turbo-santa/turbo-santa-interface/README.md

turbo-santa-interface
=====================
