turbo-santa/turbo-santa-interface/TurboSantaInterface Schematic.pdf

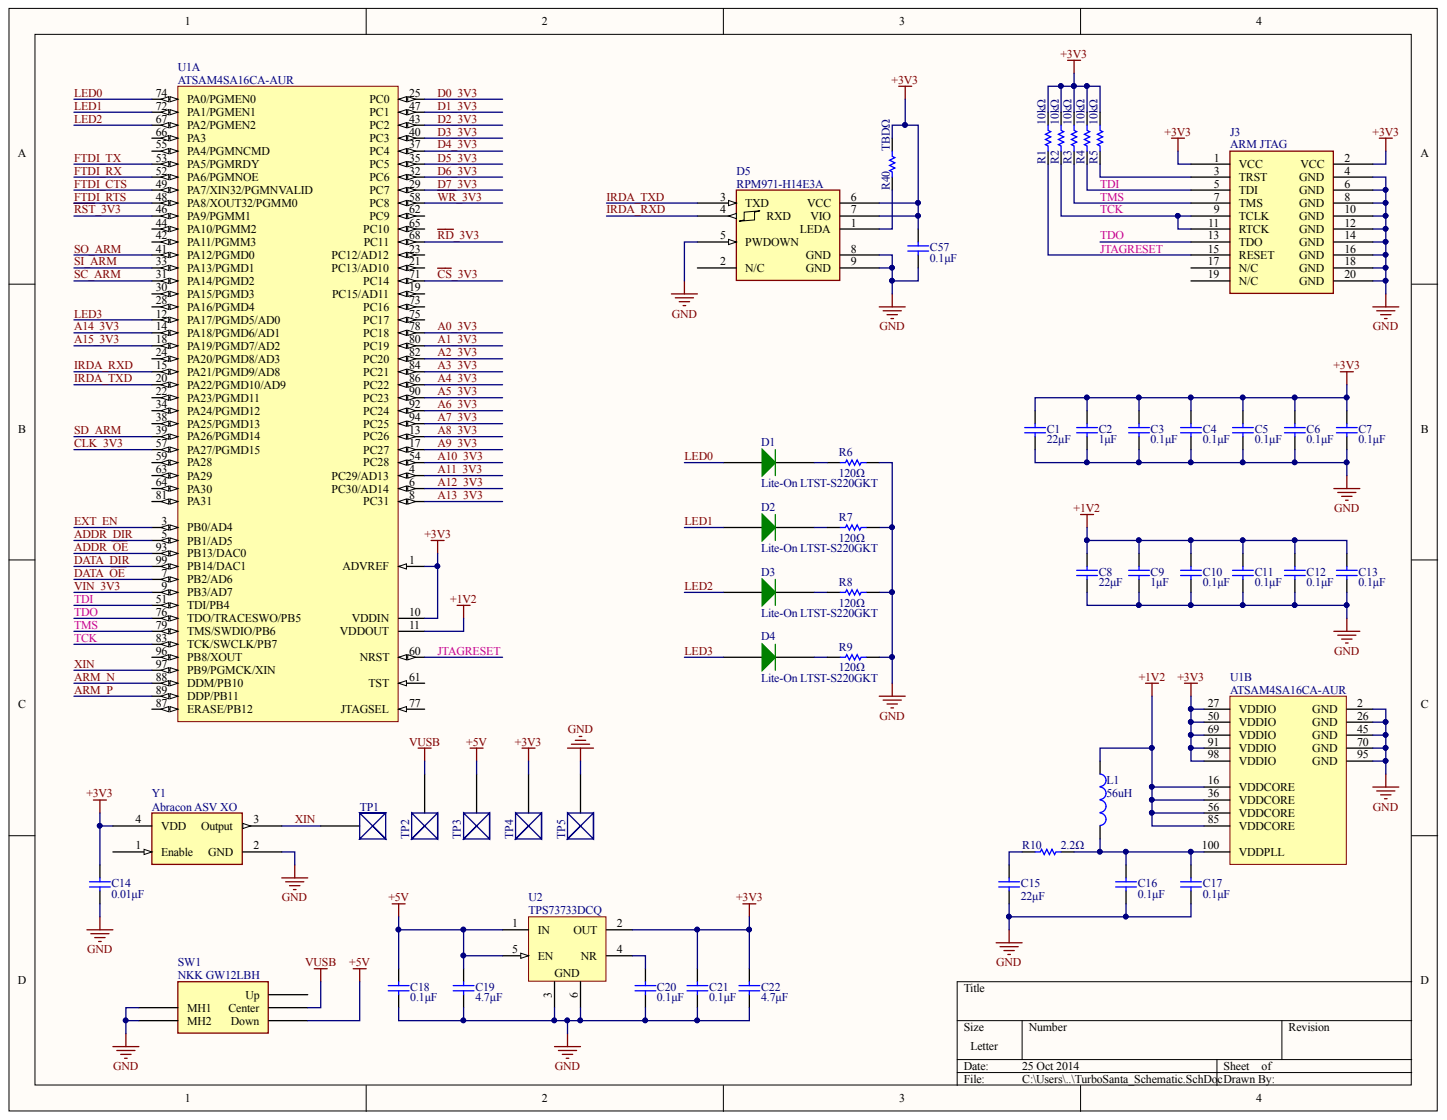
[picture p1: page 1]

TCK TMS TDI TDO

1 0
1 1

5 0 | 2 6
6 9 | 4 5
9 1 | 7 0
9 8 | 9 5

3 6
5 6

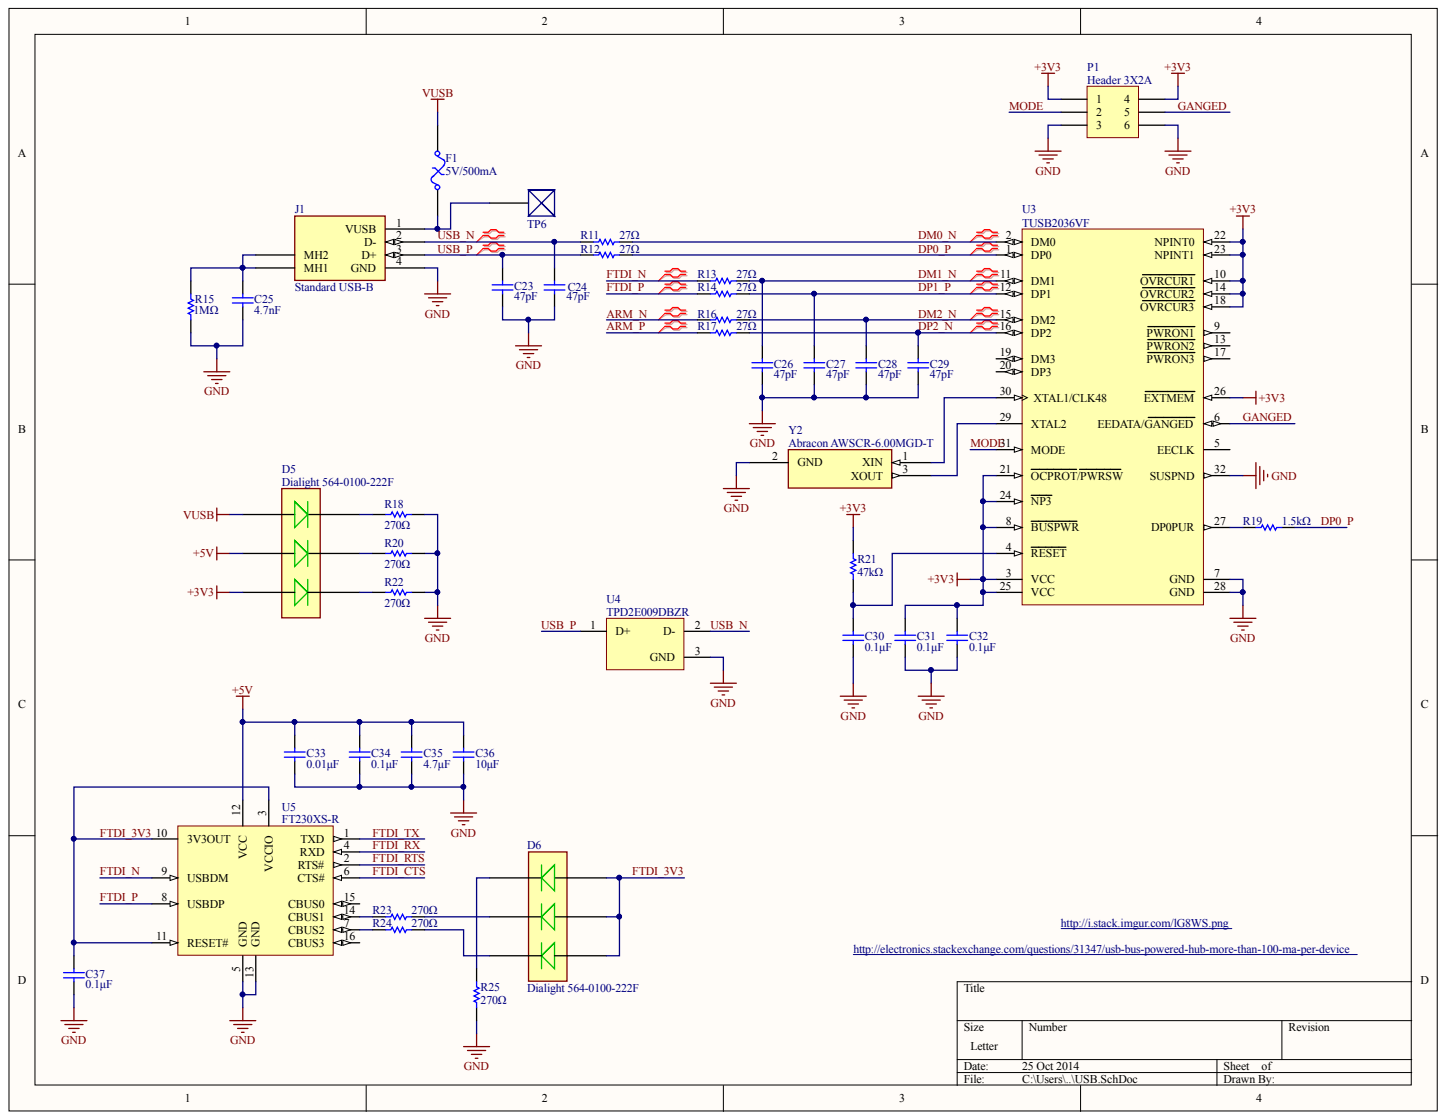
[picture p2: page 2]

XTAL2 29

MODE | MODE 31

BUSPWR 8

RESET 4

VCC 3
VCC 25

http://i.stack.imgur.com/lG8WS.png

http://electronics.stackexchange.com/questions/31347/usb-bus-powered-hub-more-than-100-ma-per-device

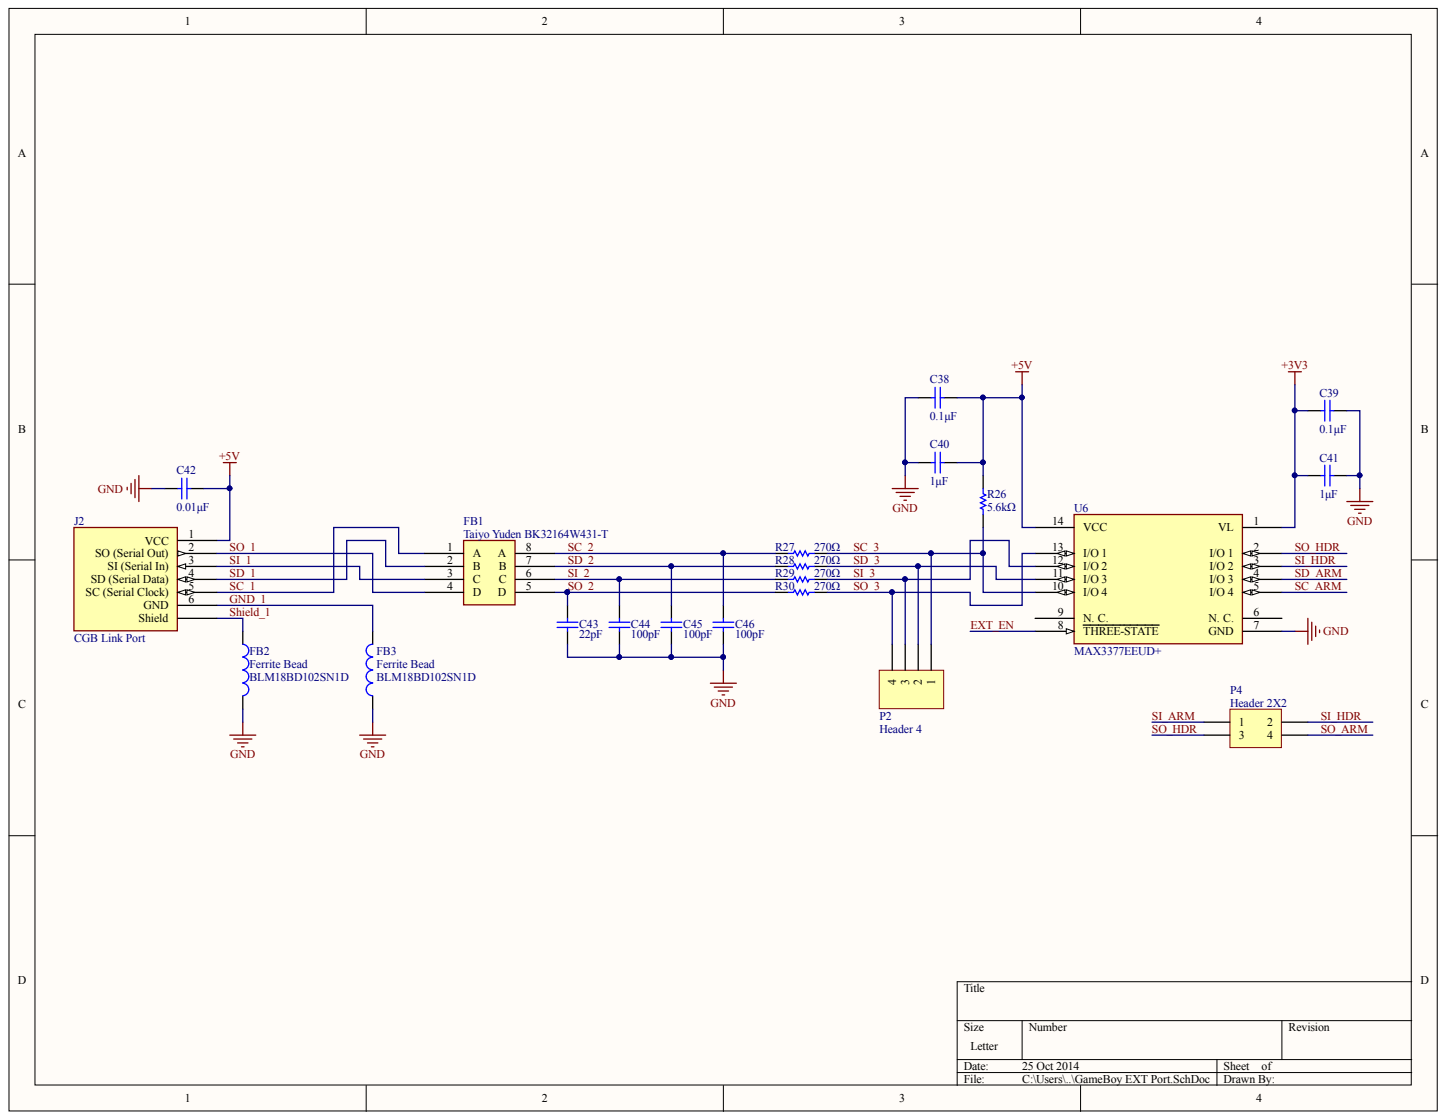
[picture p3: page 3]

3 | SI_ 1 | 2
4 | SD _ 1 | 3
5 | SC_ 1 | 4

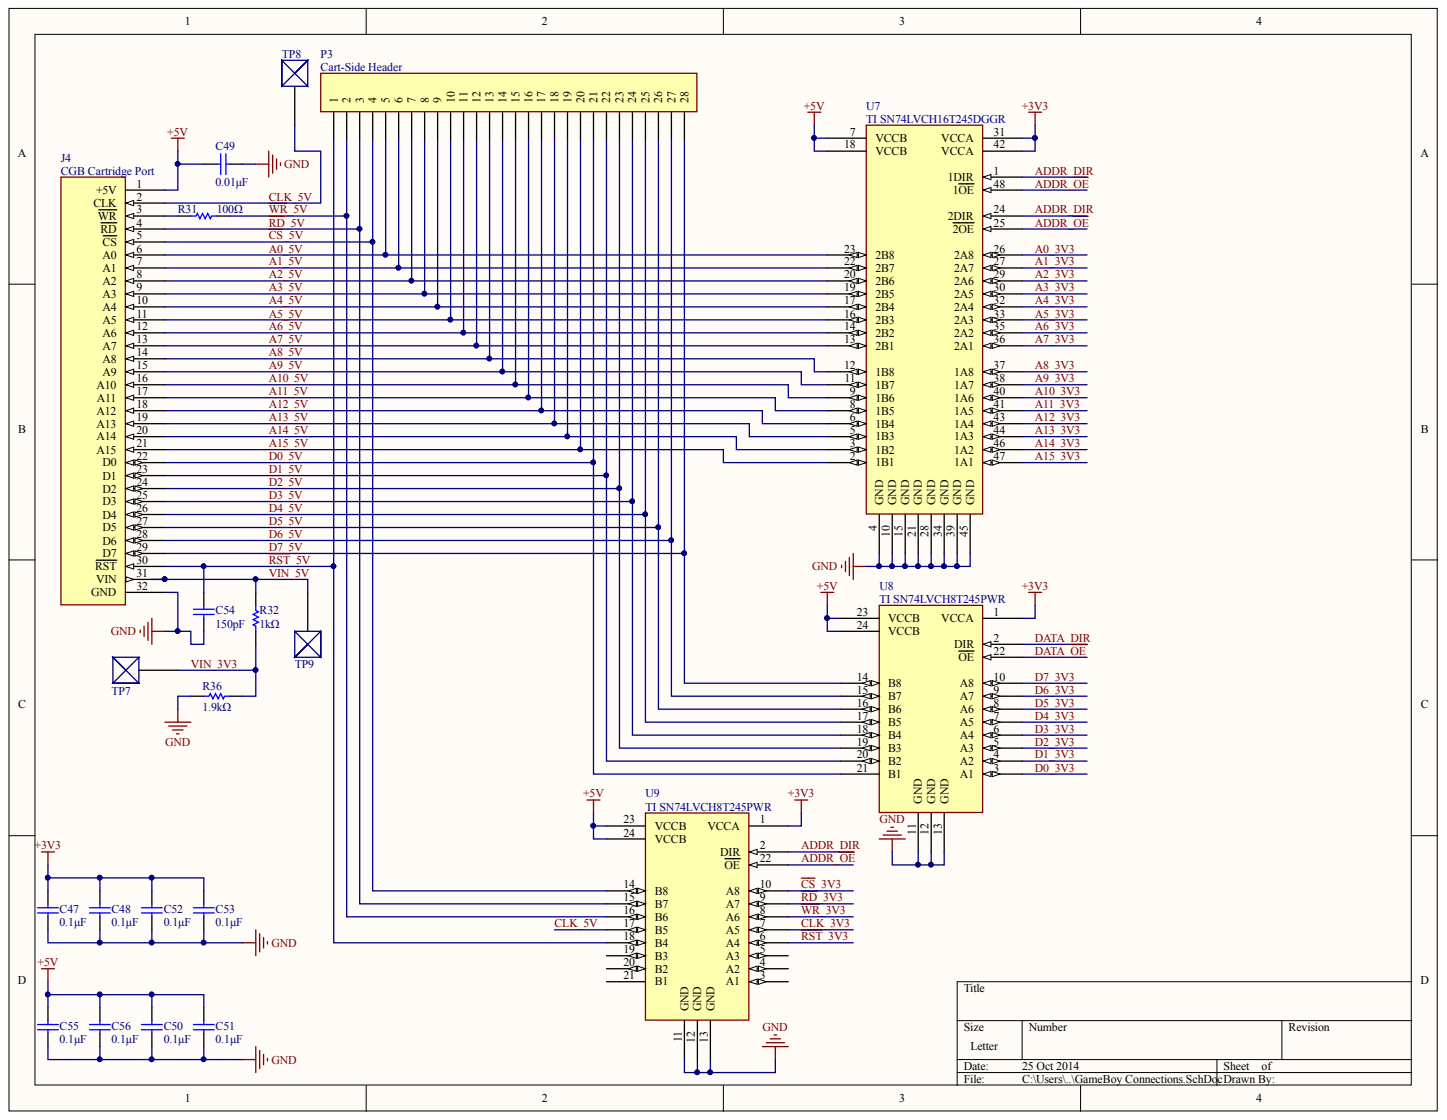
[picture p4: page 4]

3 | R3 1 | 1 0 | 0 Ω WR_ 5 V
4 | | RD _ 5 V
5 | | CS_ 5 V
6 | | A 0 _ 5 V
7 | | A 1 _ 5 V | | | | | 2 2
8 | | A 2 _ 5 V | | | | | 2 0
9 | | A 3 _ 5 V | | | | | 1 9
1 0 | | A 4 _ 5 V | | | | | 1 7
1 1 | | A 5 _ 5 V | | | | | 1 6
1 2 | | A 6 _ 5 V | | | | | 1 4
1 3 | | A 7 _ 5 V | | | | | 1 3
1 4 | | A 8 _ 5 V
1 5 | | A 9 _ 5 V

1 6 | | A 1 0 _ 5 V | | | | 1 1
1 7 | | A 1 1 _ 5 V | | | | 9
1 8 | | A 1 2 _ 5 V | | | | 8
1 9 | | A 1 3 _ 5 V | | | | 6
2 0 | | A 1 4 _ 5 V | | | | 5
2 1 | | A 1 5 _ 5 V | | | | 3
2 2 | | D 0 _ 5 V | | | | 2
2 3 | | D 1 _ 5 V
2 4 | | D 2 _ 5 V
2 5 | | D 3 _ 5 V
2 6 | | D 4 _ 5 V
2 7 | | D 5 _ 5 V
2 8 | | D 6 _ 5 V
2 9 | | D 7 _ 5 V
3 0 | | RST _ 5 V | | | GN D +5 V
3 1 | | VIN_ 5 V | | +5
3 2
