turbo-santa/turbo-santa-interface/(commit log)

2014-11-16 Added PCB Schematic for reference
2014-11-16 Started work on the Pin & Peripheral Definitions
2014-11-16 Disable the Watchdog Timer
2014-11-17 Moved files, fixed missing #include in startup.h
    [TurboSantaFirmware.c, board.h, startup.c, startup.h]
2014-11-17 Light up all four LEDs
2014-11-23 Added shifted pin bitmaskes for all I/O pins
2014-11-23 Started testing of PWM module
2014-11-23 Disabled all pullup resistors on used pins at startup
2014-11-23 Fixed missing #includes and #defines in startup.h for board.h and initialize_pio
    [startup.h]
2014-11-23 Updated PIO Controller and Peripheral definitions in board.h
2014-11-23 Started work on separate PIO driver functions
2015-01-17 Added PWM libs
2015-01-17 Fixed PLL code so the clock runs at 48MHz now.
    [startup.c]
2015-01-28 Add a generic write packet and use it to bank switch instead
